FernandoBarc/RFCar/README.md

# RFCar
RF Car Programmed in Assembly Language on PIC16F877A

Final project for Microprocessors and Microcontrollers class. 

.PDF contains the complete report on how the project was accomplished. 
.ASM files contain the assembly code for the Control/Transmitter microcontroller and the Car/Receiver microcontroller respectively.
.DSN files contain the electric diagram with working simulation of the circuits for the Control/Transmitter and Car/Receiver

Universidad Veracruzana - Electronics and Communications Engineering.
