FernandoBarc/RFCar/(list of files, drawings)

Other design files:
EMISOR.DSN
Receptor2.0.dsn
